Aswinnatesh/Closed-Loop-Speed-Control-System/README.md

# Closed-Loop-Speed-Control-System

This is a Closed loop speed control system designed for a 12 volt DC motor. It uses a IR sensor  to measure the instantaneous speed of the rotor in RPM and fed as input signal to a Microcontroller. Based on the difference in sensed and reference speeds, An PWM based Algorithm is developed and implemented to minimise the response time in achieve the required speed.

Copyright (c) 2015 Aswinnatesh | All Rights Reserved 

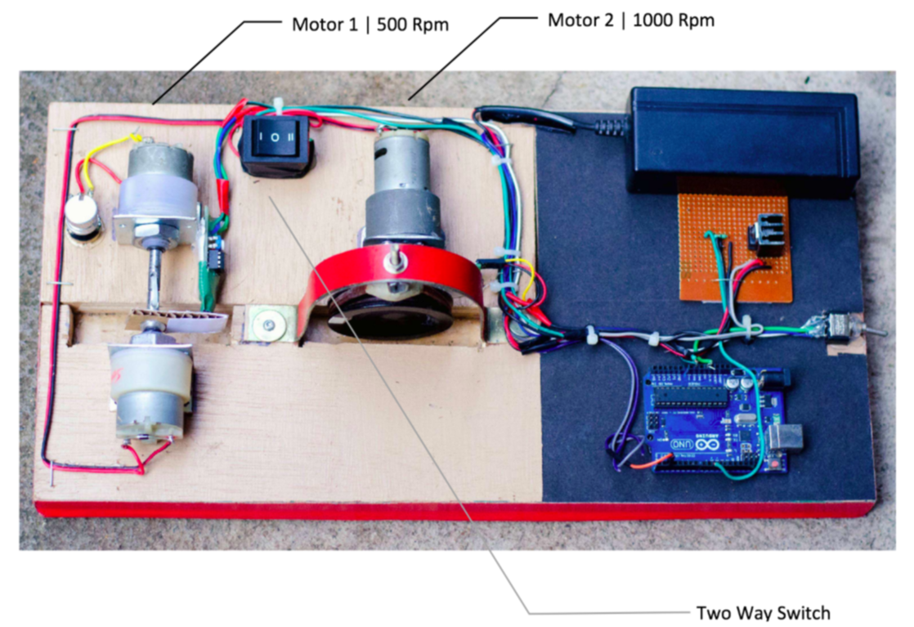
[picture p1: Screen Shot 2017-12-29 at 1.17.38 PM.png]
